Anh-phi-ngu-IT-Dien-tu/DATN_Nhung_Firmware_Raspberrypi/Motor_PCB_Design/pcb.pdf

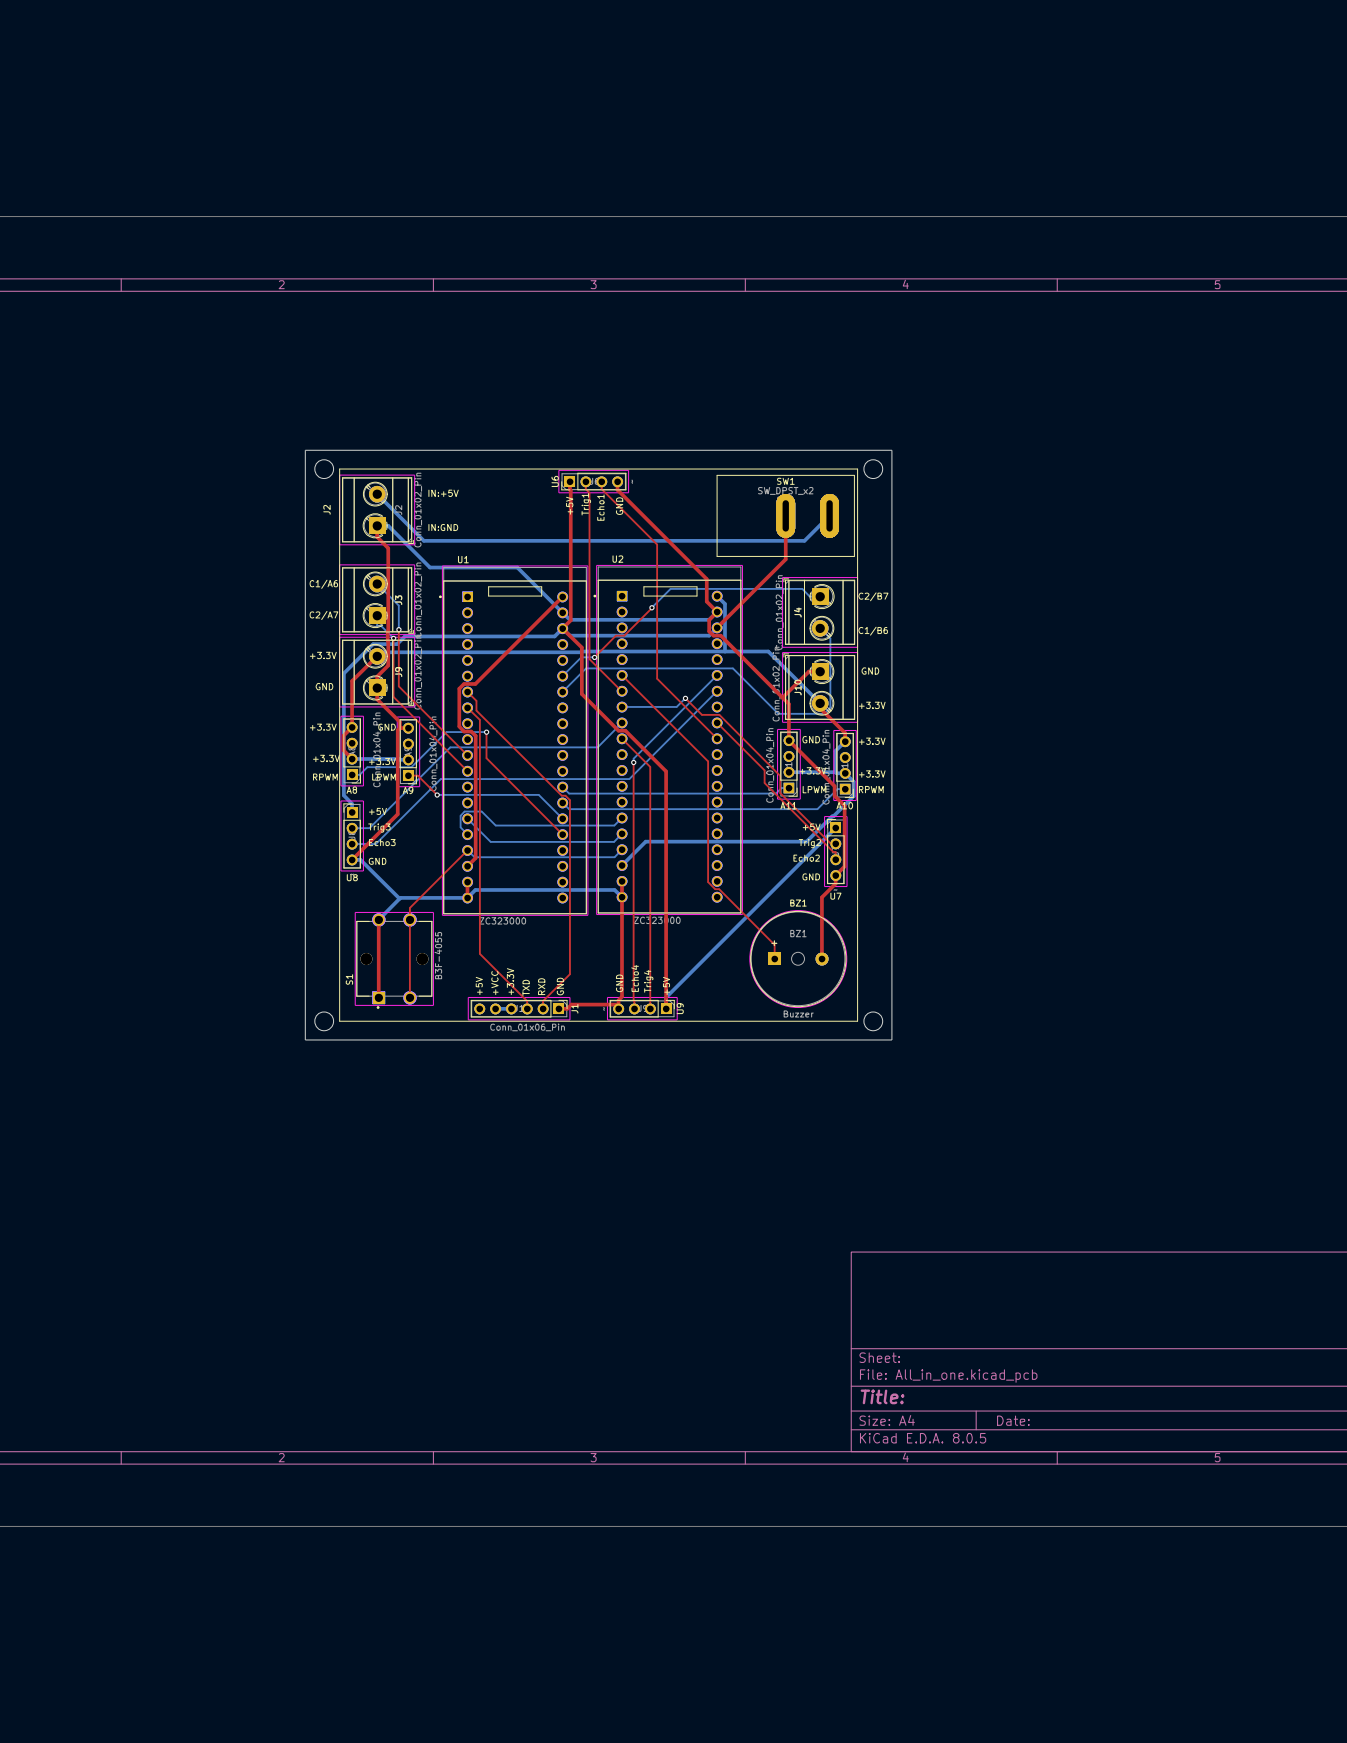
[picture p16: page 1]
