Anh-phi-ngu-IT-Dien-tu/DATN_Nhung_Firmware_Raspberrypi/Motor_PCB_Design/schematic.pdf

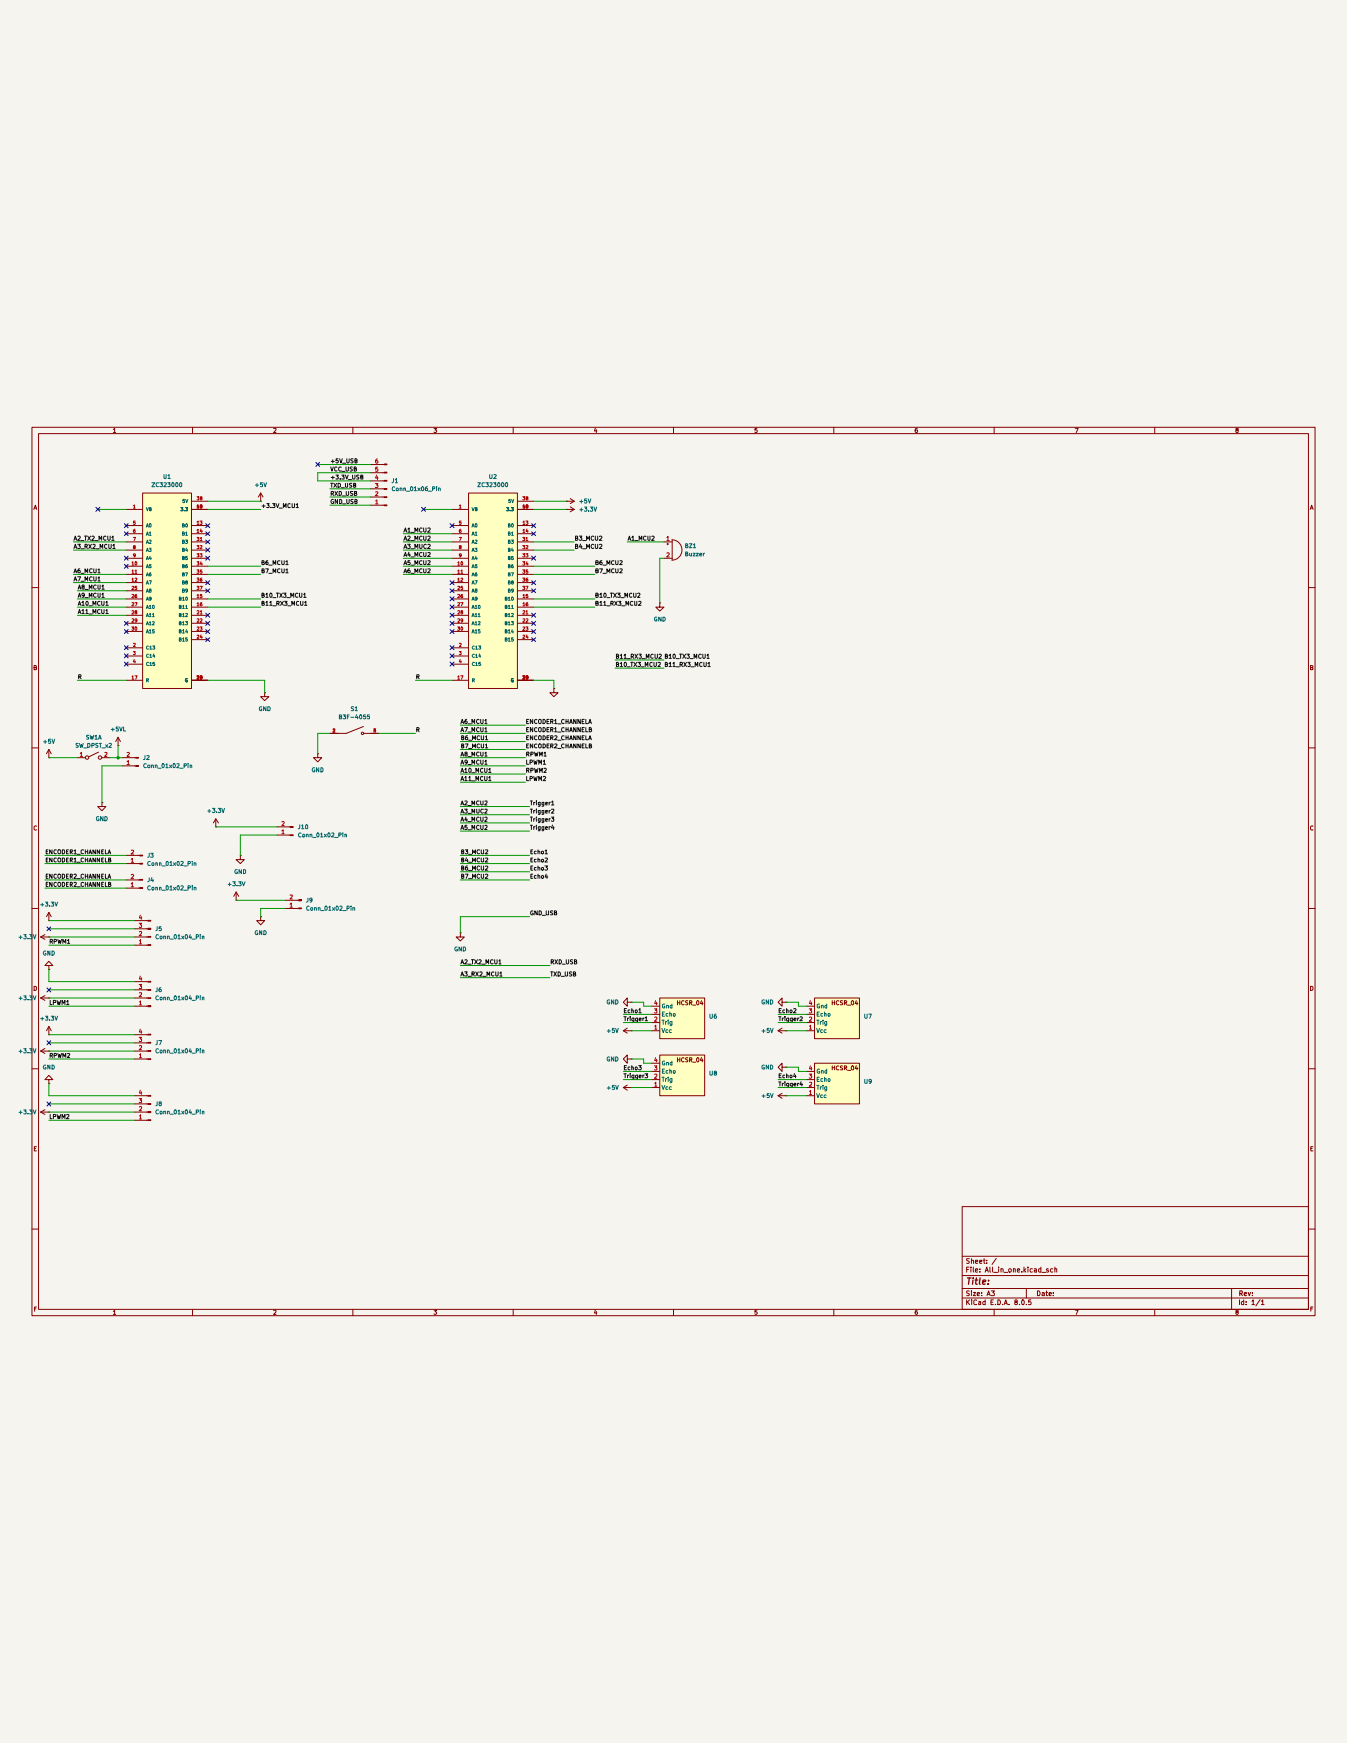
[picture p17: page 1]
