Anh-phi-ngu-IT-Dien-tu/DATN_Nhung_Firmware_Raspberrypi/Motor_PCB_Design/All_in_one/All_in_one.kicad_pcb

## KiCad design Motor_PCB_Design/All_in_one/All_in_one.kicad_pcb (2025-06-24)

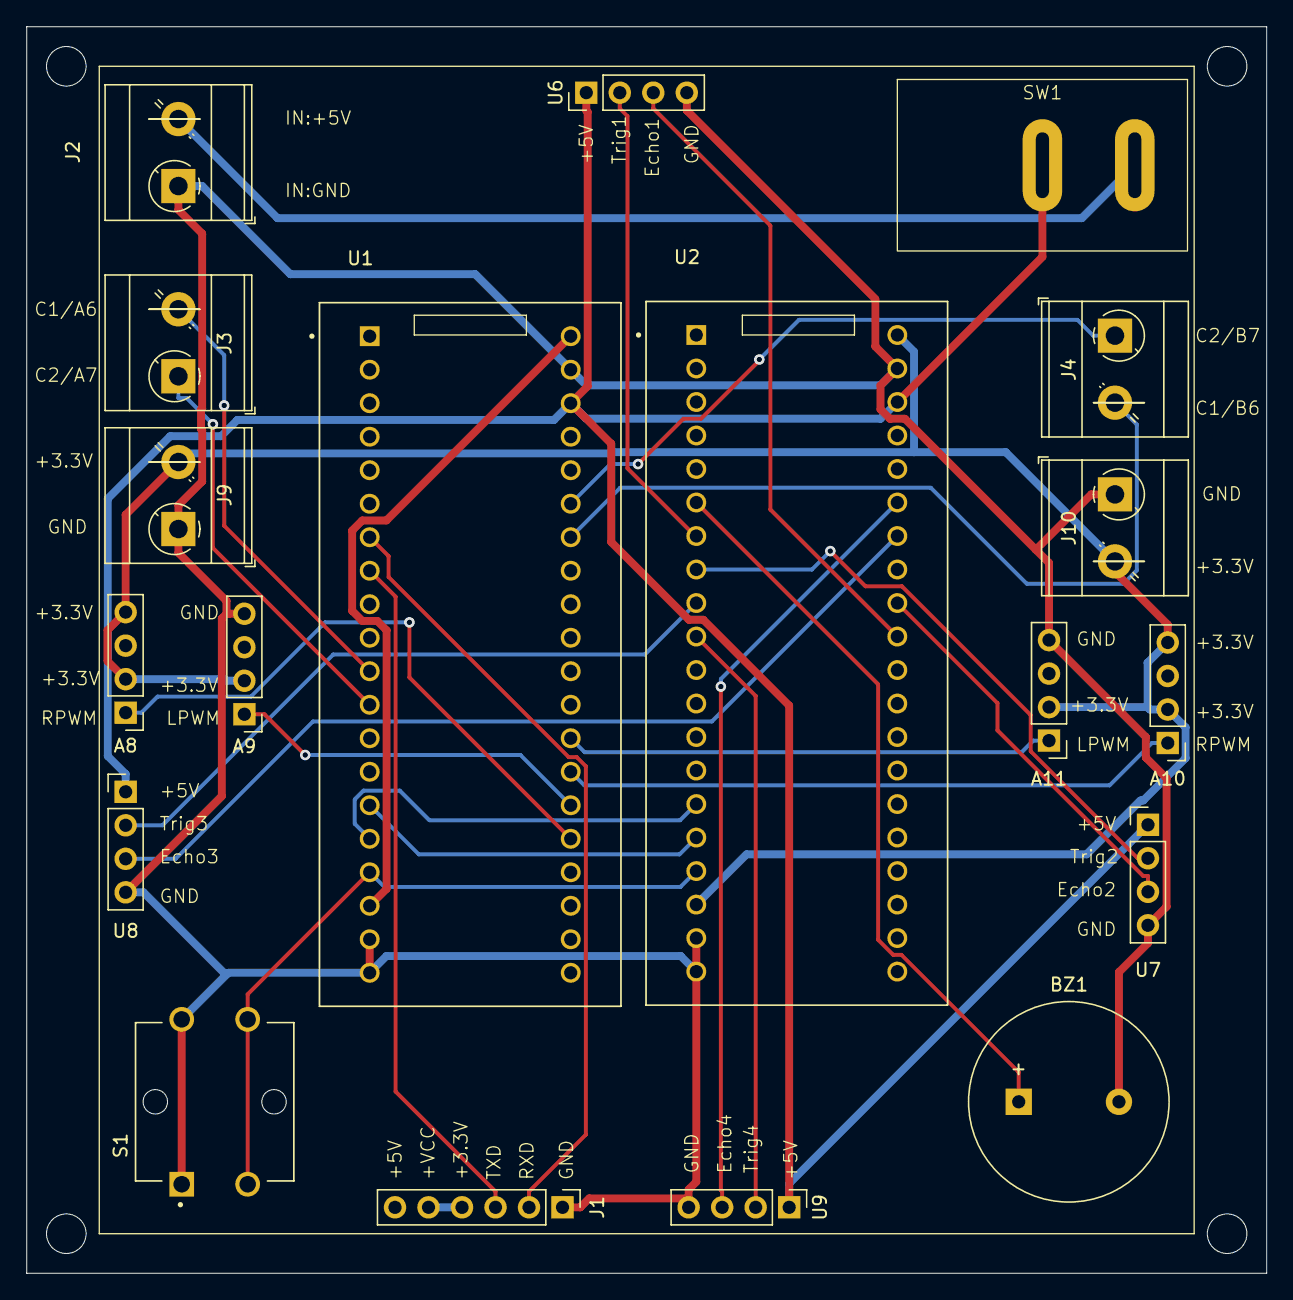
[picture p18: board All_in_one.kicad_pcb from above]

Board: 2 copper layers, 94.0 x 94.5 mm, 19 parts (0 on the bottom side), 28 nets.

Parts:
A8, A9, A10, A11: Conn_01x04_Pin; PinHeader_1x04_P2.54mm_Vertical
BZ1: Buzzer; Buzzer_15x7.5RM7.6
J1: Conn_01x06_Pin; PinHeader_1x06_P2.54mm_Vertical
J2, J3, J4, J9, J10: Conn_01x02_Pin; TerminalBlock_MetzConnect_Type073_RT02602HBLU_1x02_P5.08mm_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
S1: B3F-4055; SW_B3F-4055
SW1: SW_DPST_x2; Switch_6A_21x22x15custom
U1, U2: ZC323000; MODULE_ZC323000
U6, U7, U8, U9: PinHeader_1x04_P2.54mm_Vertical

Connections:
+3.3V: A8.2, A8.4, A9.2, A10.2, A10.4, A11.2, J9.2, J10.2, U2.18 (3.3), U2.40 (3.3)
+5V: SW1.1 (A), U1.38 (5V), U2.38 (5V), U6.1 (Vcc), U7.1 (Vcc), U8.1 (Vcc), U9.1 (Vcc)
+5VL: J2.2, SW1.2 (B)
/+3.3V_MCU1: U1.18 (3.3), U1.40 (3.3)
/+3.3V_USB: J1.4, J1.5
/A1_MCU2: BZ1.1 (+), U2.6 (A1)
/A2_MCU2: U2.7 (A2), U6.2 (Trig)
/A2_TX2_MCU1: J1.2, U1.7 (A2)
/A3_MUC2: U2.8 (A3), U7.2 (Trig)
/A3_RX2_MCU1: J1.3, U1.8 (A3)
/A4_MCU2: U2.9 (A4), U8.2 (Trig)
/A5_MCU2: U2.10 (A5), U9.2 (Trig)
/A6_MCU1: J3.2, U1.11 (A6)
/A7_MCU1: J3.1, U1.12 (A7)
/A8_MCU1: A8.1, U1.25 (A8)
/A9_MCU1: A9.1, U1.26 (A9)
/A10_MCU1: A10.1, U1.27 (A10)
/A11_MCU1: A11.1, U1.28 (A11)
/B3_MCU2: U2.31 (B3), U6.3 (Echo)
/B4_MCU2: U2.32 (B4), U7.3 (Echo)
/B6_MCU1: J4.2, U1.34 (B6)
/B6_MCU2: U2.34 (B6), U8.3 (Echo)
/B7_MCU1: J4.1, U1.35 (B7)
/B7_MCU2: U2.35 (B7), U9.3 (Echo)
/B10_TX3_MCU1: U1.15 (B10), U2.16 (B11)
/B10_TX3_MCU2: U1.16 (B11), U2.15 (B10)
/R: S1.3, S1.4, U1.17 (R), U2.17 (R)
GND: A9.4, A11.4, BZ1.2 (-), J1.1, J2.1, J9.1, J10.1, S1.1, S1.2, U1.19 (G), U1.20 (G), U1.39 (G), U2.19 (G), U2.20 (G), U2.39 (G), U6.4 (Gnd), U7.4 (Gnd), U8.4 (Gnd), U9.4 (Gnd)
