Anh-phi-ngu-IT-Dien-tu/DATN_Nhung_Firmware_Raspberrypi/Motor/Core/Src/main.c

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
/* Includes ------------------------------------------------------------------*/
#include "main.h"

/* USER CODE BEGIN Includes */
#include "Robot_control.h"
#include "BTS7960_control.h"
#include "PID.h"
/* USER CODE END Includes */

/* USER CODE BEGIN PD */

//////

/* USER CODE END PD */

/* USER CODE BEGIN PM */

/*storing data variables*/
uint8_t tx_buffer2[12];
uint8_t rx_buffer2[8];

uint8_t final_rx_buffer2[8];
uint8_t uart3_rx_buffer[8];
uint8_t uart3_tx_buffer[8];

/*interrupt control variables*/
int8_t uart3_allow_tx;
int8_t uart3_rx_check;
int8_t uart2_allow_tx;
int8_t uart2_rx_check;
int8_t timer2_check;
#if Visualize_Measurement==1
int8_t i=0;
#endif


/*My variables*/
Robot_model_typedef R;
Motor_measurement_command_typedef M1;
Motor_measurement_command_typedef M2;
PIDControllers_Typedef pidM1;
PIDControllers_Typedef pidM2;

/* USER CODE END PM */

TIM_HandleTypeDef htim1;
TIM_HandleTypeDef htim2;
TIM_HandleTypeDef htim3;
TIM_HandleTypeDef htim4;

UART_HandleTypeDef huart2;
UART_HandleTypeDef huart3;
DMA_HandleTypeDef hdma_usart2_rx;
DMA_HandleTypeDef hdma_usart2_tx;
DMA_HandleTypeDef hdma_usart3_rx;
DMA_HandleTypeDef hdma_usart3_tx;

void SystemClock_Config(void);
static void MX_GPIO_Init(void);
static void MX_DMA_Init(void);
static void MX_TIM1_Init(void);
static void MX_TIM2_Init(void);
static void MX_TIM3_Init(void);
static void MX_TIM4_Init(void);
static void MX_USART2_UART_Init(void);
static void MX_USART3_UART_Init(void);
/* USER CODE BEGIN 0 */
void Deal_Timer2()
{
	CalculateMotorsOmegas(&R, &M1, &M2);
	pidMotorControl(&htim3, &M1, &pidM1, MOTOR_1, CONTROL_NORMAL);
	pidMotorControl(&htim4, &M2, &pidM2, MOTOR_2, CONTROL_INVERT);
	calculatePredictionValue(&R, M1.distance, M2.distance);
#if Visualize_Measurement==1
	if(i==5)
	{
		sprintf((char *)tx_buffer2,"%.4f/%.4f/%d/%d/%d/%d\n",M1.rpm_measurement,M2.rpm_measurement,M1.current_cnt,M1.previous_cnt,M2.current_cnt,M2.previous_cnt);
		HAL_UART_Transmit_DMA(&huart2, tx_buffer2, strlen((char*)tx_buffer2));
		i=0;
	}
	i++;
#endif
#if Visualize_Measurement==0
	memcpy(tx_buffer2,&R.sl,12);
	HAL_UART_Transmit_DMA(&huart2, tx_buffer2, 12);
#endif

}

void HAL_TIM_PeriodElapsedCallback(TIM_HandleTypeDef *htim)
{
	if(htim->Instance==TIM2)
	{
		timer2_check=1;
	}
}

void HAL_UART_RxHalfCpltCallback(UART_HandleTypeDef *huart)
{
	if(huart->Instance==USART2)
	{
		memcpy(final_rx_buffer2,rx_buffer2,4);
	}
}

void HAL_UART_RxCpltCallback(UART_HandleTypeDef *huart)
{
	if(huart->Instance==USART1)
	{

	}
	else if(huart->Instance==USART2)
	{
		memcpy(final_rx_buffer2+4,rx_buffer2+4,4);
		uart2_rx_check=1;
	}
	else if(huart->Instance==USART3)
	{
		uart3_rx_check=1;
	}
}
/* USER CODE END 0 */

/**
  * @brief  The application entry point.
  * @retval int
  */
int main(void)
{

  /* MCU Configuration--------------------------------------------------------*/

  /* Reset of all peripherals, Initializes the Flash interface and the Systick. */
  HAL_Init();

  /* Configure the system clock */
  SystemClock_Config();

  /* Initialize all configured peripherals */
  MX_GPIO_Init();
  MX_DMA_Init();
  MX_TIM1_Init();
  MX_TIM2_Init();
  MX_TIM3_Init();
  MX_TIM4_Init();
  MX_USART2_UART_Init();
  MX_USART3_UART_Init();
  /* USER CODE BEGIN 2 */

  pidControllersInit(&pidM1, 2, 2, 0.01, 0.02, 0.02,MAX_RPM);
  pidControllersInit(&pidM2, 2, 2, 0.01,0.02, 0.02, MAX_RPM);

  HAL_TIM_PWM_Start(&htim1, TIM_CHANNEL_1);
  HAL_TIM_PWM_Start(&htim1, TIM_CHANNEL_2);
  HAL_TIM_PWM_Start(&htim1, TIM_CHANNEL_3);
  HAL_TIM_PWM_Start(&htim1, TIM_CHANNEL_4);
  HAL_TIM_Base_Start_IT(&htim2);
  HAL_TIM_Encoder_Start(&htim3, TIM_CHANNEL_ALL);
  HAL_TIM_Encoder_Start(&htim4,TIM_CHANNEL_ALL);
  HAL_UART_Receive_DMA(&huart2, rx_buffer2, 8);
  HAL_UART_Receive_DMA(&huart3, uart3_rx_buffer, 1);
  /* USER CODE END 2 */

  /* Infinite loop */
  /* USER CODE BEGIN WHILE */
  while (1)
  {
    /* USER CODE END WHILE */

    /* USER CODE BEGIN 3 */
	  if(timer2_check==1)
	  {
		  Deal_Timer2();
		  timer2_check=0;
	  }
	  if(uart2_rx_check==1)
		{
			memcpy(&R,final_rx_buffer2,8);
			uart2_rx_check=0;
		}
		if(uart3_rx_check==1)
		{
			MCU2FrameHandler(uart3_rx_buffer, &R);
			uart3_rx_check=0;
		}

  }
  /* USER CODE END 3 */
}

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
