Anh-phi-ngu-IT-Dien-tu/DATN_Nhung_Firmware_Raspberrypi/Motor/Do_an_tot_nghiep_Motor_Node.ioc

Mcu.UserName=STM32F103C8Tx
PA10.Signal=S_TIM1_CH3
PA11.Signal=S_TIM1_CH4
PA13.Signal=SYS_JTMS-SWDIO
PA14.Signal=SYS_JTCK-SWCLK
PA2.Signal=USART2_TX
PA3.Signal=USART2_RX
PA6.Signal=S_TIM3_CH1
PA7.Signal=S_TIM3_CH2
PA8.Signal=S_TIM1_CH1
PA9.Signal=S_TIM1_CH2
PB10.Signal=USART3_TX
PB11.Signal=USART3_RX
PB6.Signal=S_TIM4_CH1
PB7.Signal=S_TIM4_CH2
PD0-OSC_IN.Signal=RCC_OSC_IN
PD1-OSC_OUT.Signal=RCC_OSC_OUT
