Anh-phi-ngu-IT-Dien-tu/DATN_Nhung_Firmware_Raspberrypi/Motor/Core/Inc/main.h

#define Visualize_Measurement 0
#define Calibrate_Parameters 0
