Anh-phi-ngu-IT-Dien-tu/DATN_Nhung_Firmware_Raspberrypi/(notices)

Notices in the files:
Motor/Core/Src/main.c:
Copyright (c) 2025 STMicroelectronics.
All rights reserved.
This software is licensed under terms that can be found in the LICENSE file
